MatthewIsHere/leos-dualpower-pcb/LEOS-dualpower.kicad_pcb

## KiCad design LEOS-dualpower.kicad_pcb (2026-03-25)

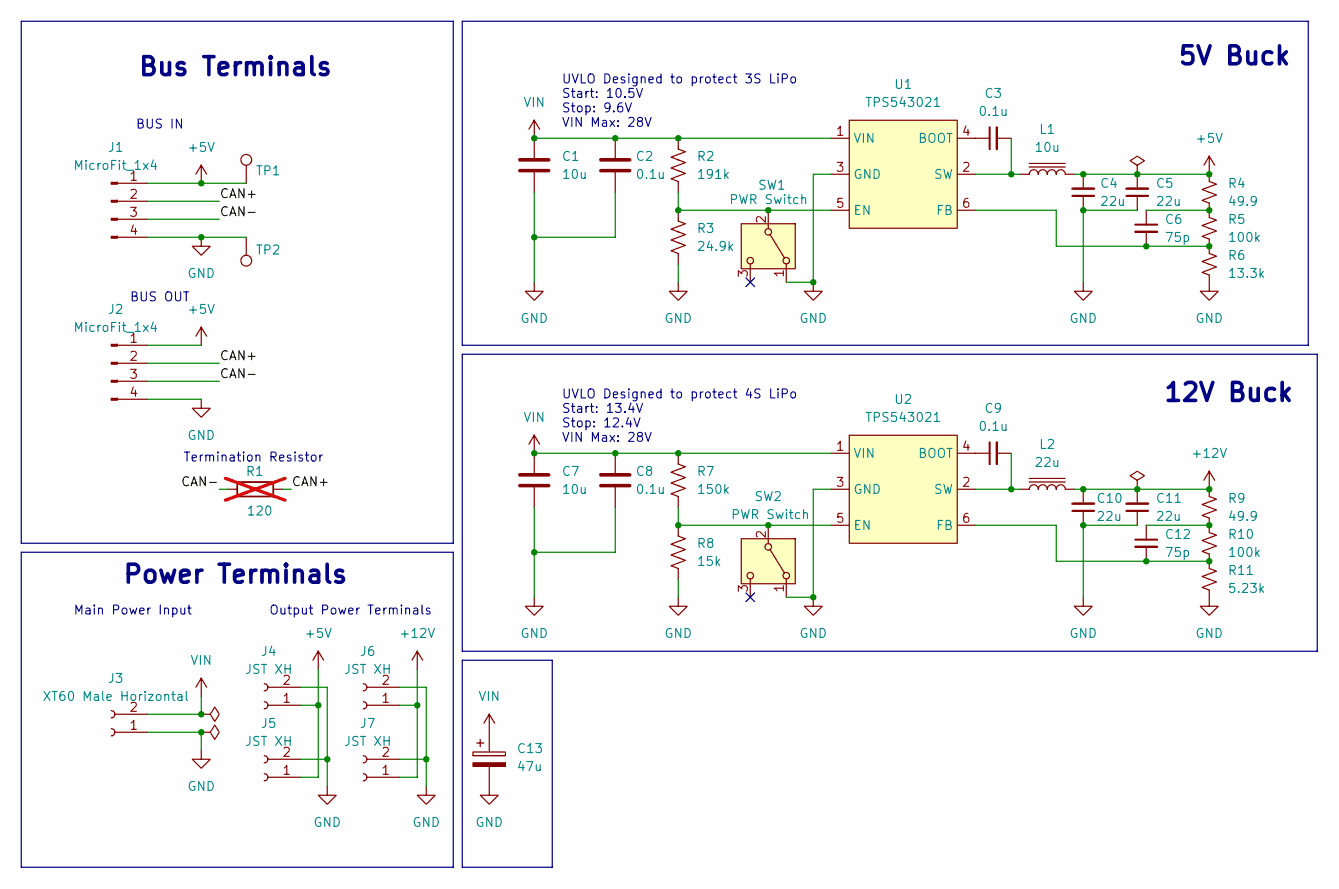
[picture p1: schematic LEOS-dualpower.kicad_sch, LEOS DualPower]

Parts:
C1, C7: 10u; C_1206_3216Metric_Pad1.33x1.80mm_HandSolder; MPN CL31B106KBHNNNE; Digikey 1276-6767-1-ND
C2, C3, C8, C9: 0.1u; C_1206_3216Metric_Pad1.33x1.80mm_HandSolder; MPN CL31B104KEHSFNE; Digikey 1276-3083-1-ND
C4, C5, C10, C11: 22u; C_1206_3216Metric_Pad1.33x1.80mm_HandSolder; MPN TMK316BBJ226ML-T; Digikey 587-3246-1-ND
C6, C12: 75p; C_1206_3216Metric_Pad1.33x1.80mm_HandSolder; MPN CC1206JRNPO9BN750; Digikey 13-CC1206JRNPO9BN750CT-ND
C13: 47u; C_Elec_6.3x7.7; MPN EDH476M050A9HAA; Digikey 399-18135-1-ND
J1, J2: MicroFit_1x4; Molex_MicroFit3.0_43650-0410_1x04_Horizontal; MPN 0436500409; Digikey WM1882CT-ND
J3: XT60 Male Horizontal; AMASS_XT60IPW-M_1x03_P7.20mm_Horizontal; MPN XT60IPW-M; Digikey amazon.com/dp/B0CQ2LM4JY
J4, J5, J6, J7: JST XH; JST_XH_S2B-XH-A_1x02_P2.50mm_Horizontal; MPN S2B-XH-A; Digikey 455-S2B-XH-A-ND
L1: 10u; L_Bourns_SRR1260; MPN SRR1280-100M; Digikey SRR1280-100MCT-ND
L2: 22u; L_Bourns_SRR1260; MPN SRR1280-220M; Digikey SRR1280-220MCT-ND
R1: 120; R_Axial_DIN0207_L6.3mm_D2.5mm_P7.62mm_Horizontal; MPN CF14JT120R; Digikey CF14JT120RCT-ND; not fitted
R2: 191k; R_1206_3216Metric_Pad1.30x1.75mm_HandSolder; MPN CRCW1206191KFKEA; Digikey 541-191KFCT-ND
R3: 24.9k; R_1206_3216Metric_Pad1.30x1.75mm_HandSolder; MPN CRCW120624K9FKEA; Digikey 541-24.9KFCT-ND
R4, R9: 49.9; R_1206_3216Metric_Pad1.30x1.75mm_HandSolder; MPN CRCW120649R9FKEAC; Digikey 541-4185-1-ND
R5, R10: 100k; R_1206_3216Metric_Pad1.30x1.75mm_HandSolder; MPN CRCW1206100KFKEAC; Digikey 541-4173-1-ND
R6: 13.3k; R_1206_3216Metric_Pad1.30x1.75mm_HandSolder; MPN CRCW120613K3FKEA; Digikey 541-13.3KFCT-ND
R7: 150k; R_1206_3216Metric_Pad1.30x1.75mm_HandSolder; MPN CRCW1206150KFKEAC; Digikey 541-CRCW1206150KFKEACCT-ND
R8: 15k; R_1206_3216Metric_Pad1.30x1.75mm_HandSolder; MPN CRCW120615K0FKEAC; Digikey 541-CRCW120615K0FKEACCT-ND
R11: 5.23k; R_1206_3216Metric_Pad1.30x1.75mm_HandSolder; MPN CRCW12065K23FKEA; Digikey 541-5.23KFCT-ND
SW1, SW2: PWR Switch; SW_Slide_SPDT_Angled_CK_OS102011MA1Q; MPN OS102011MA1QN1; Digikey CKN9559-ND
TP1: 5V Test Point; TestPoint_Loop_D2.60mm_Drill0.9mm_Beaded; MPN 5000; Digikey 36-5000-ND
TP2: GND Test Point; TestPoint_Loop_D2.60mm_Drill0.9mm_Beaded; MPN 5001; Digikey 36-5001-ND
U1, U2: TPS543021; SOT-563; MPN TPS543021DRLR; Digikey 296-TPS543021DRLRCT-ND

Connections:
+5V: C4.2, C5.2, J1.1, J2.1, J4.1, J5.1, L1.2, R4.1, TP1.1
+12V: C10.2, C11.2, J6.1, J7.1, L2.2, R9.1
/CAN+: J1.2, J2.2, R1.2
/CAN-: J1.3, J2.3, R1.1
GND: C1.2, C2.2, C4.1, C5.1, C7.2, C8.2, C10.1, C11.1, C13.2, J1.4, J2.4, J3.1, J4.2, J5.2, J6.2, J7.2, R3.2, R6.2, R8.2, R11.2, SW1.1 (A), SW2.1 (A), TP2.1, U1.3 (GND), U2.3 (GND)
unnamed: C6.1, R4.2, R5.1
unnamed: C12.1, R9.2, R10.1
unnamed: R2.2, R3.1, SW1.2 (B), U1.5 (EN)
unnamed: R7.2, R8.1, SW2.2 (B), U2.5 (EN)
unnamed: C3.1, U1.4 (BOOT)
unnamed: C6.2, R5.2, R6.1, U1.6 (FB)
unnamed: C3.2, L1.1, U1.2 (SW)
unnamed: C9.1, U2.4 (BOOT)
unnamed: C12.2, R10.2, R11.1, U2.6 (FB)
unnamed: C9.2, L2.1, U2.2 (SW)
VIN: C1.1, C2.1, C7.1, C8.1, C13.1, J3.2, R2.1, R7.1, U1.1 (VIN), U2.1 (VIN)

Notes on the sheet:
UVLO Designed to protect 3S LiPo Start: 10.5V Stop: 9.6V VIN Max: 28V
Output Power Terminals
Termination Resistor
Bus Terminals
12V Buck
BUS IN
UVLO Designed to protect 4S LiPo Start: 13.4V Stop: 12.4V VIN Max: 28V
Main Power Input
5V Buck
Power Terminals
BUS OUT

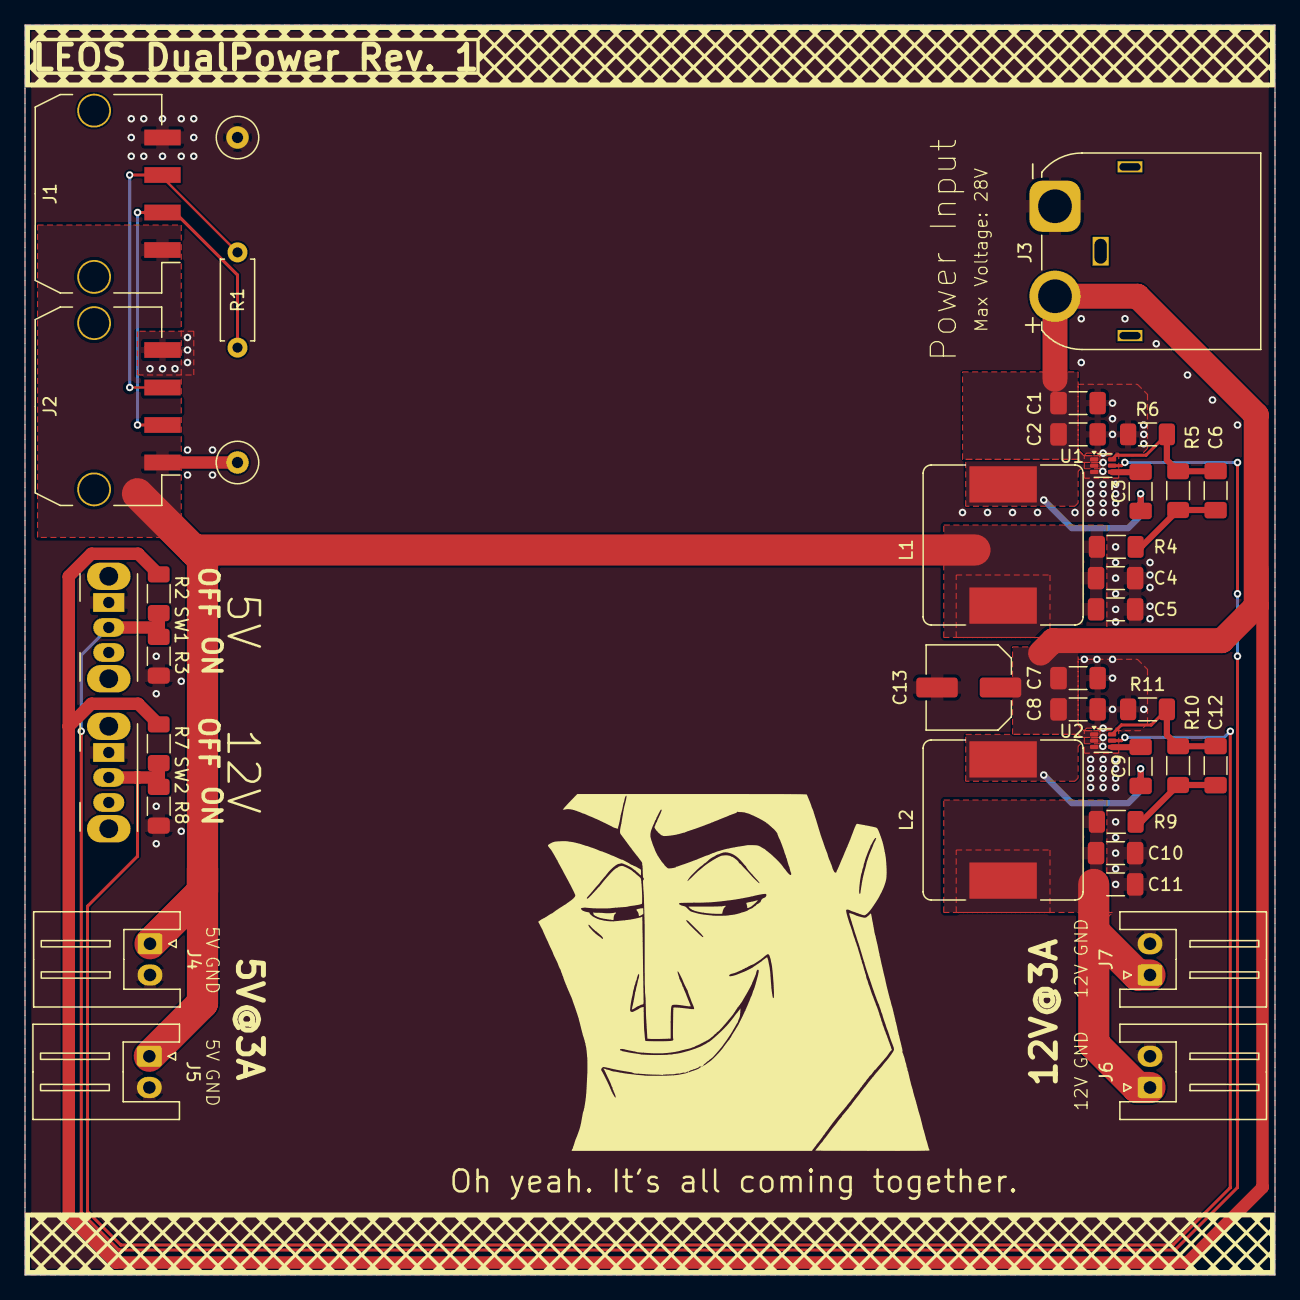
[picture p2: board LEOS-dualpower.kicad_pcb from above]

Board: 2 copper layers, 100.0 x 100.0 mm, 39 parts (0 on the bottom side), 16 nets.
