MatthewIsHere/leos-dualpower-pcb/(commit log)

2026-03-20 create new pcb with dual 12V, 5V independent buck converters with simple components
    [LEOS-dualpower.kicad_pcb, LEOS-dualpower.kicad_sch, LEOS-stack-template.kicad_pcb, LEOS-stack-template.kicad_sch, canbus.kicad_sch, connectors.kicad_sch]
2026-03-25 Fix output locations for generated files
    [LEOS-dualpower.kicad_pcb, LEOS-dualpower.kicad_sch]
